IowaScaledEngineering/mrbw-sat/doc/bill-of-materials.ods

Part # | Mfr | Description | Qty | RefDes
LTC3528 | LTC | Step-Up DC/DC | 1 | U1
ATmega328P-AU | Atmel | Microcontroller | 1 | U2
CPDT6-5V4-HF |  | ESD Diodes | 1 | U4
 | Generic | 499k, 1% Resistor (0805) | 1 | R1
 | Generic | 287k, 1% Resistor (0805) | 1 | R2
 | Generic | 1k Resistor (0805) | 3 | R3,R5,R6
 | Generic | 10k Resistor (0805) | 1 | R4
91A1A-B24-(A/B)20L | Bourns | 100k Potentiometer | 1 | P1
 | Generic | 10uF 25V X7R/X5R (0805) | 2 | C2,C4
 | Generic | 33pF 16V NP0 (0805) | 1 | C3
 | Generic | 0.1uF 16V X7R/X5R (0805) | 3 | C5,C6,C7
 | Generic | 22pF 16V NP0 (0805) | 2 | C8,C9
 | Generic | 1uF 16V X7R/X5R (0805) | 2 | C10,C12
 | Generic | 8.2pF 16V NP0 (0805) | 1 | C11
MSS6132-472MLB | Coilcraft | 4.7uH Inductor | 1 | L1
ATS111BSM-1 |  | 11.0592MHz, 18pF Crystal (HC-49-SMT) | 1 | Y1
Si2333DDS |  | P-channel FET | 1 | MP1
SMP4-SBC | Bivar | Red/Green LED | 1 | D1
NPPN101BFLD-RC |  | Xbee Sockets (SMT) | 2 | XU3
M2013ES1W03 | NKK | SPDT Center-Off Toggle Switch | 1 | SW1
D6R90 F1 | C&K | Pushbutton | 1 | SW2
CT2195MST |  | 5-pos DIP switch | 1 | SW3
OSTTC022162 | OST | Dual 0.2" Terminal Blocks | 1 | J1
 |  | 2x3 male header | 6 | J2
1553BBKBAT | Hammond | Case | 1
515-1192-00550F | Dialight | Light Pipe | 1 | For D1
 |  | Knob (user preference, for 1/4” potentiometer shafting) | 1 | For P1
