IowaScaledEngineering/mrbw-sat/pg/mrbw-sat-v1.1-9935337/mrbw-sat-pcb.pdf

# mrbw-sat.pcb

# 1. Table of Contents (This Page) Created on Wed Jul 8 20:06:34 2015

# 2. top 3. bottom 4. outline 5. plated-drill 6. unplated-drill 7. componentmask 8. soldermask 9. topsilk 10. bottomsilk 11. toppaste 12. topassembly 13. bottomassembly 14. fab

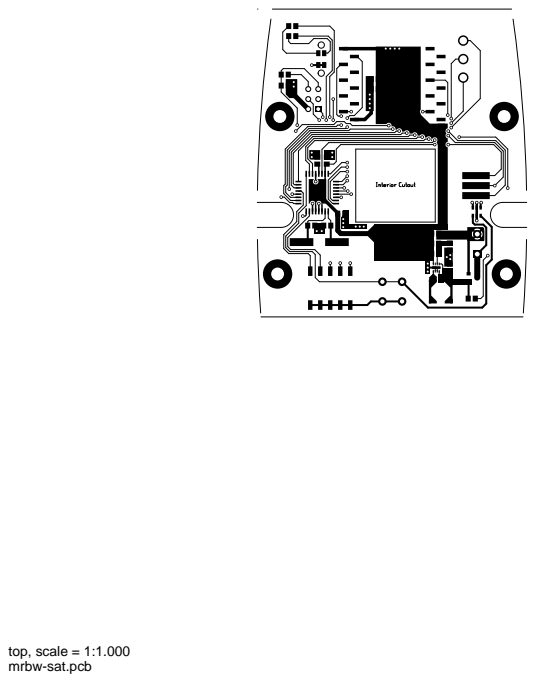
[picture p1: page 2]
top, scale = 1:1.000

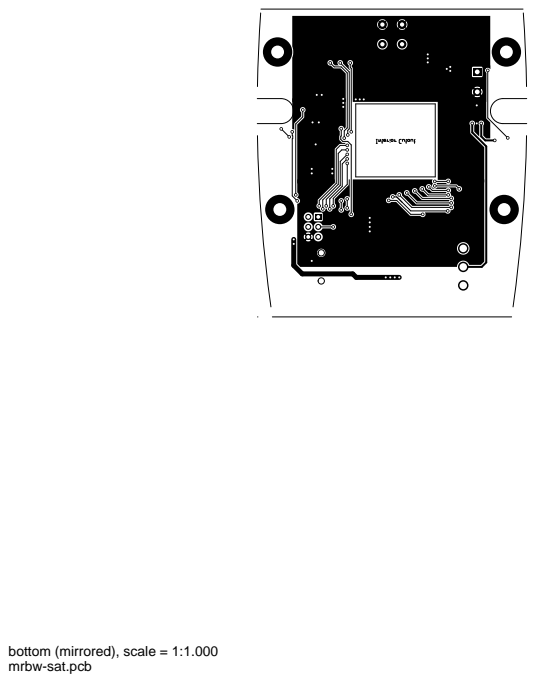
[picture p2: page 3]

bottom (mirrored), scale = 1:1.000

outline, scale = 1:1.000

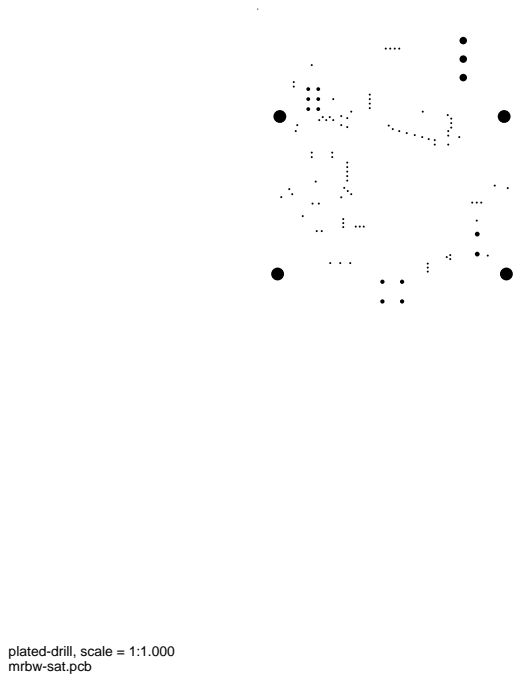
[picture p3: page 5]

plated-drill, scale = 1:1.000

unplated-drill, scale = 1:1.000

topmask, scale = 1:1.000

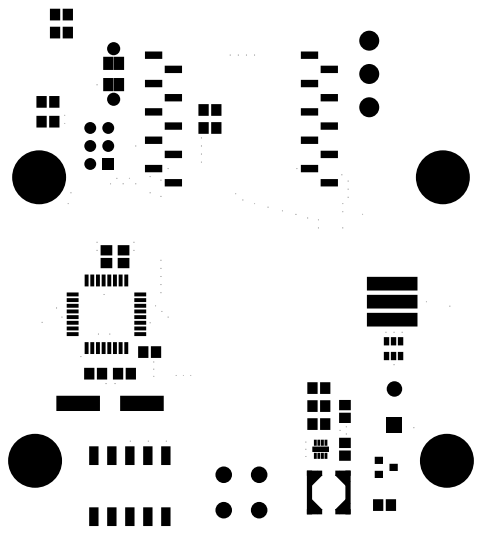
[picture p4: figure]

bottommask (mirrored), scale = 1:1.000

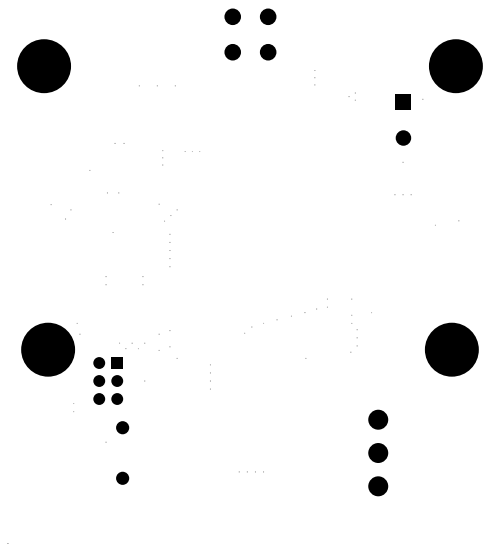
[picture p5: figure]
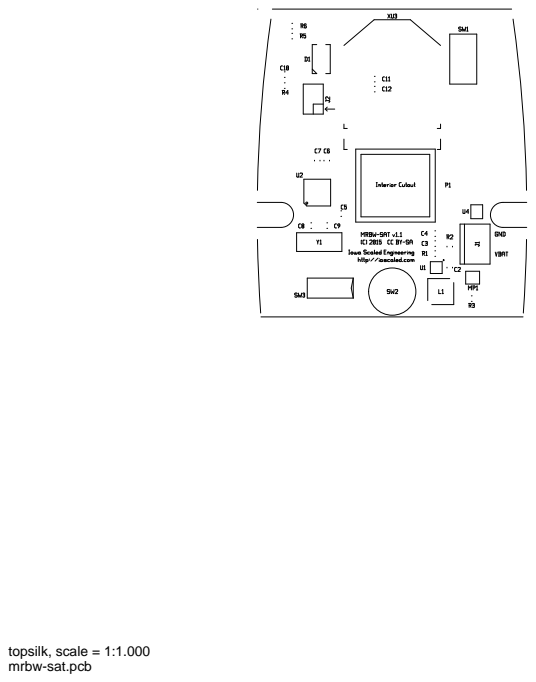
[picture p6: page 9]
topsilk, scale = 1:1.000

bottomsilk (mirrored), scale = 1:1.000

toppaste, scale = 1:1.000

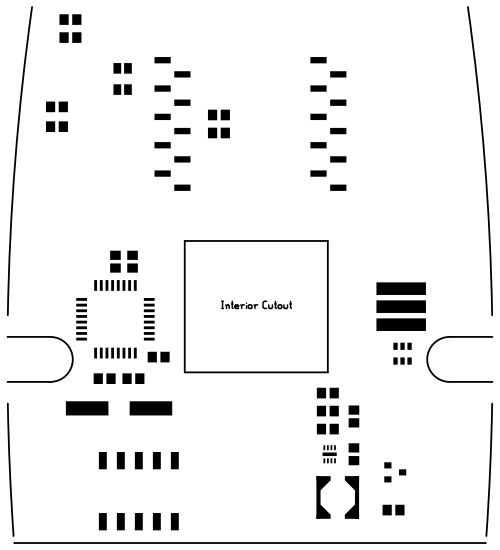
[picture p7: figure]
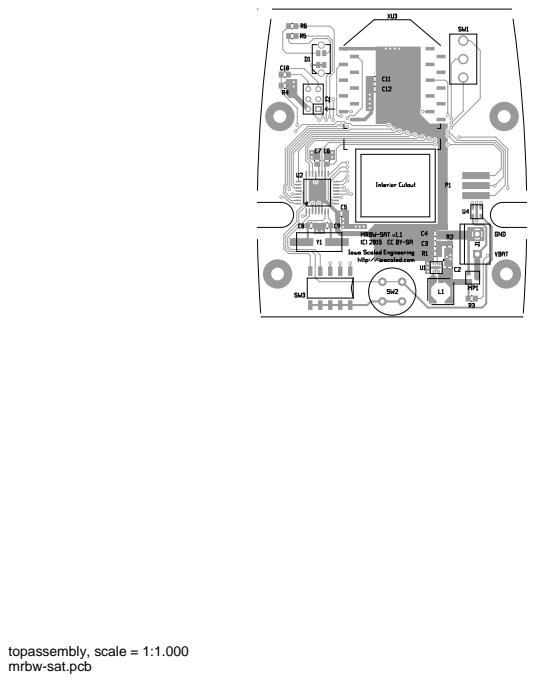
[picture p8: page 12]
topassembly, scale = 1:1.000

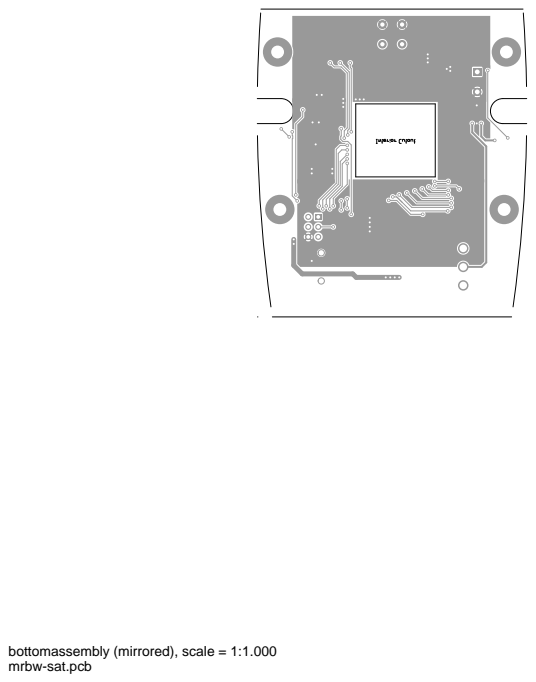
[picture p9: page 13]

bottomassembly (mirrored), scale = 1:1.000

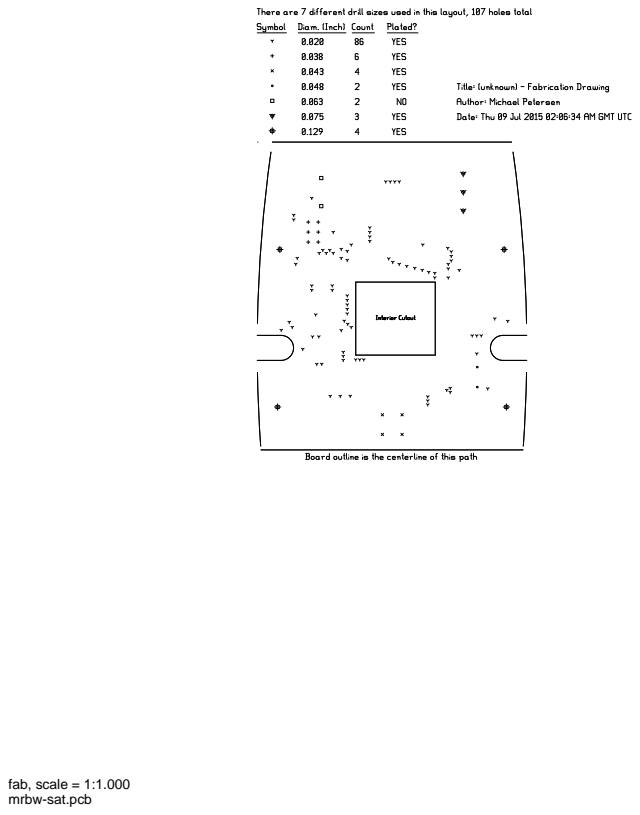
[picture p10: page 14]
fab, scale = 1:1.000
