IowaScaledEngineering/mrbw-sat/pg/mrbw-sat-v1.1-9935337/mrbw-sat.pdf

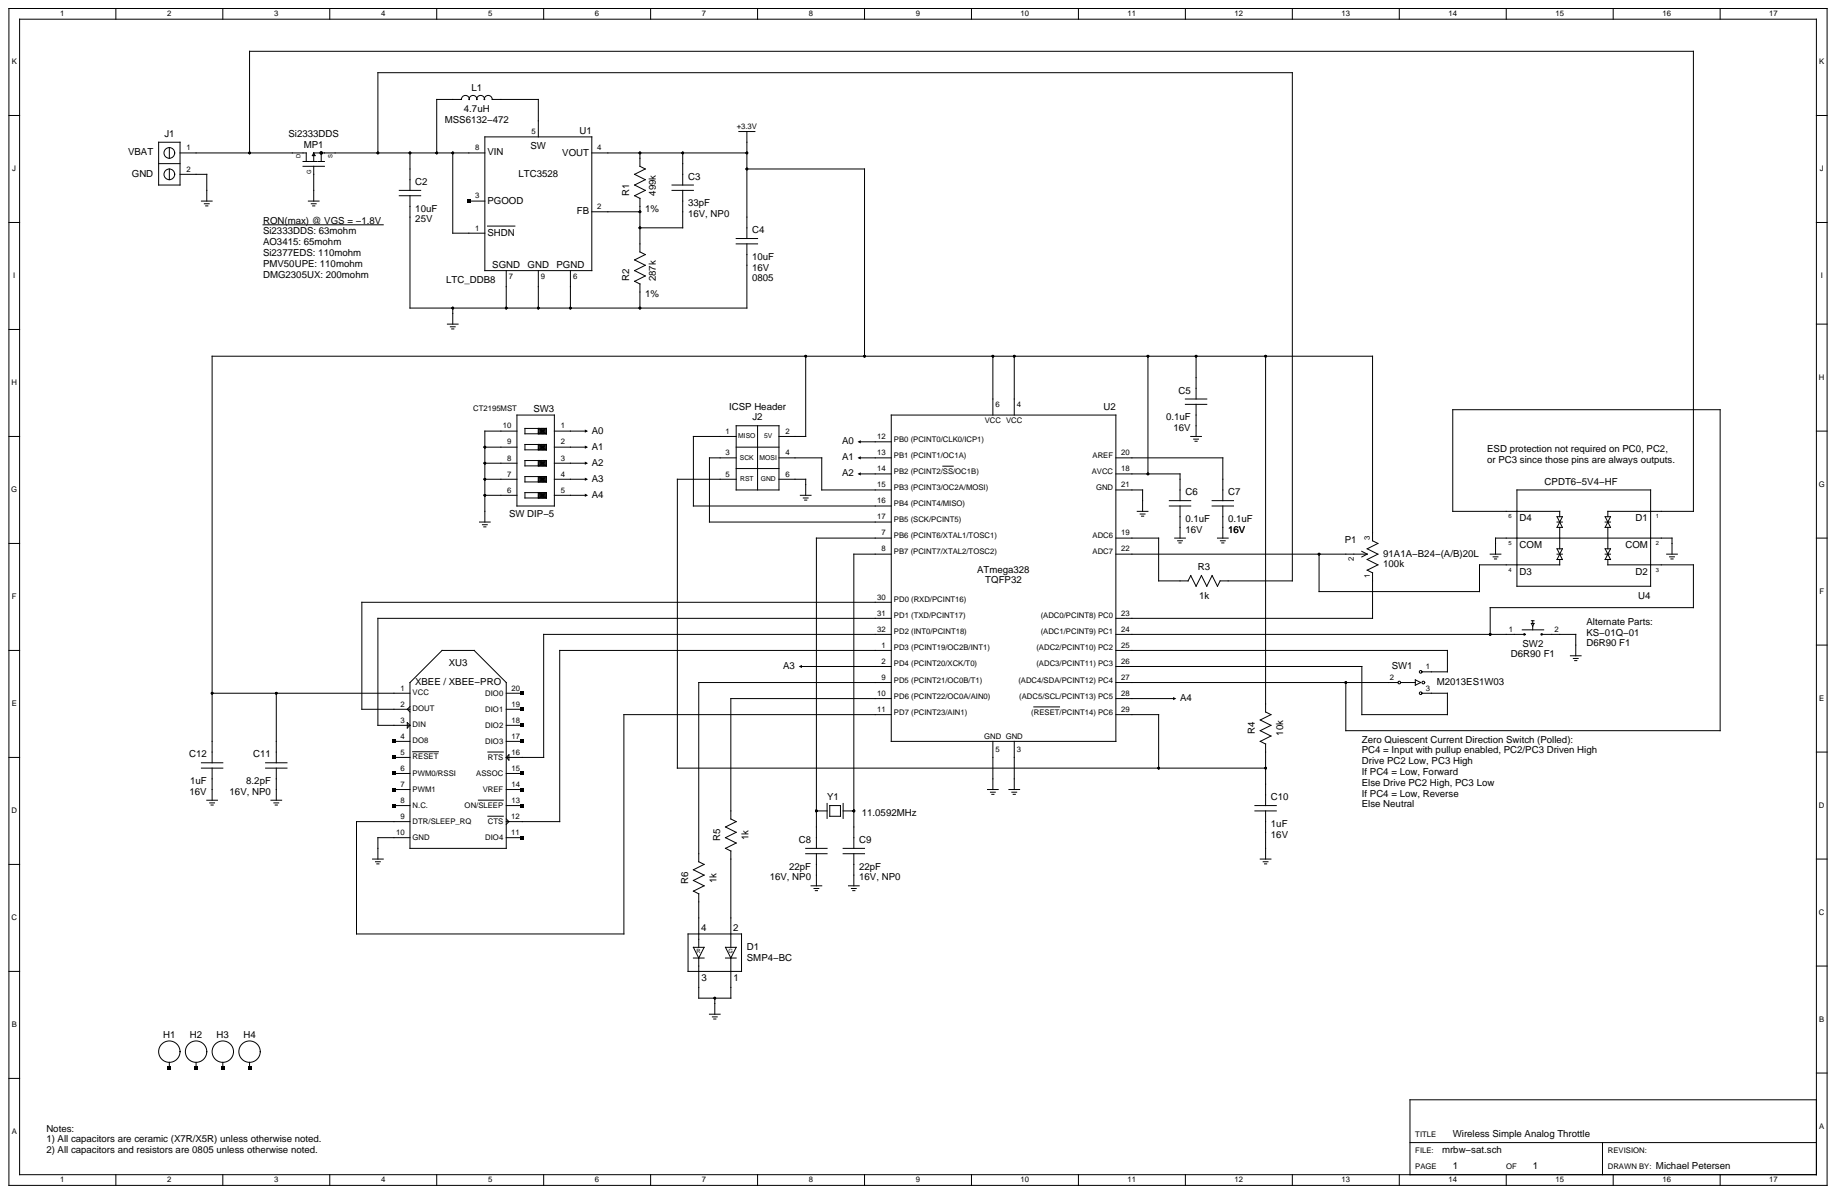
[picture p11: page 1]

ESD protection not required on PC0, PC2,
or PC3 since those pins are always outputs.

Zero Quiescent Current Direction Switch (Polled):
PC4 = Input with pullup enabled, PC2/PC3 Driven High
Drive PC2 Low, PC3 High
If PC4 = Low, Forward
Else Drive PC2 High, PC3 Low
If PC4 = Low, Reverse
Else Neutral

Notes:
1) All capacitors are ceramic (X7R/X5R) unless otherwise noted.
2) All capacitors and resistors are 0805 unless otherwise noted.

Wireless Simple Analog Throttle
mrbw−sat.sch
