IowaScaledEngineering/mrbw-sat/pg/mrbw-sat-v1.0-r1273/mrbw-sat-pcb.pdf

# mrbw-sat.pcb

# 1. Table of Contents (This Page) Created on Sun May 24 20:47:13 2015

# 2. top 3. bottom 4. outline 5. plated-drill 6. unplated-drill 7. componentmask 8. soldermask 9. topsilk 10. bottomsilk 11. toppaste 12. topassembly 13. bottomassembly 14. fab

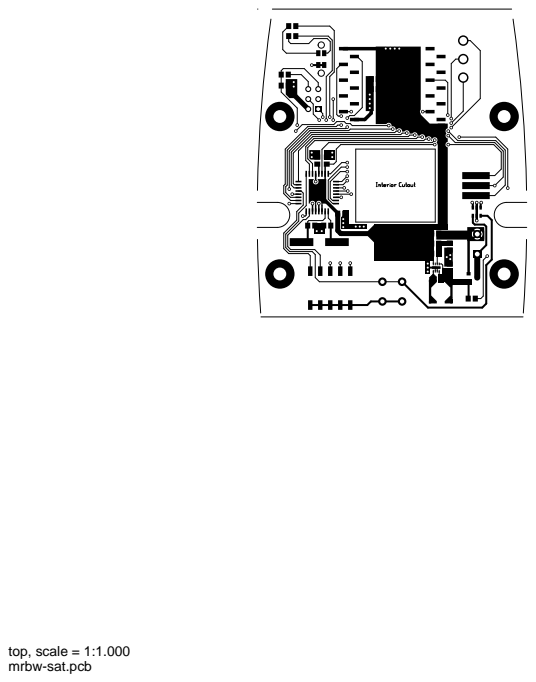
[picture p12: page 2]
top, scale = 1:1.000

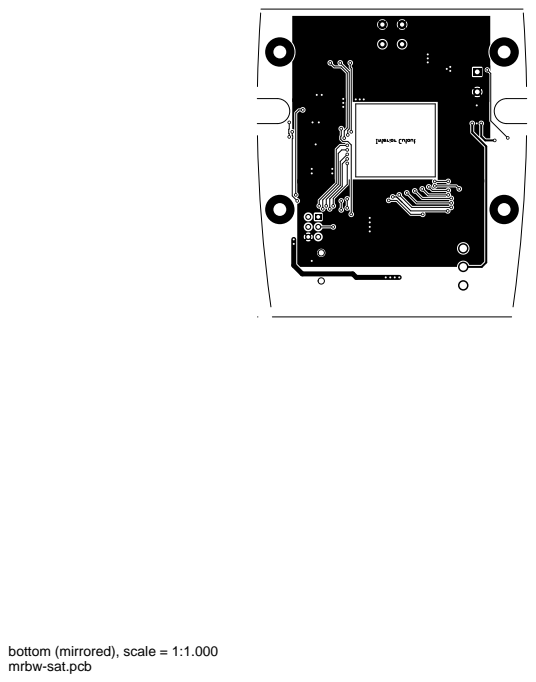
[picture p13: page 3]

bottom (mirrored), scale = 1:1.000

outline, scale = 1:1.000

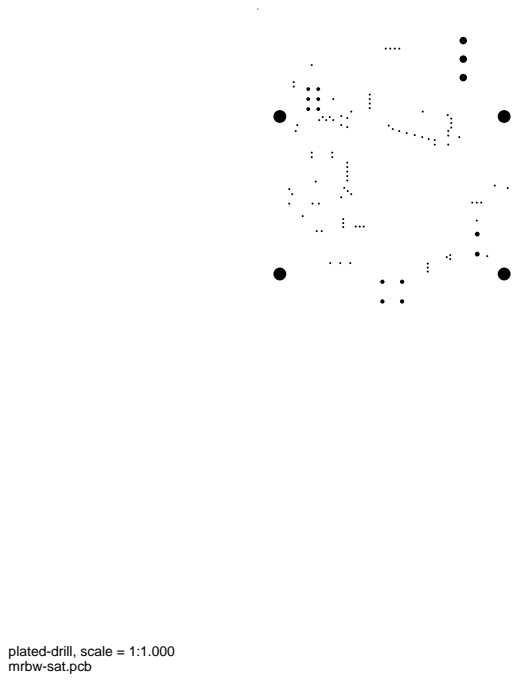
[picture p14: page 5]

plated-drill, scale = 1:1.000

unplated-drill, scale = 1:1.000

topmask, scale = 1:1.000

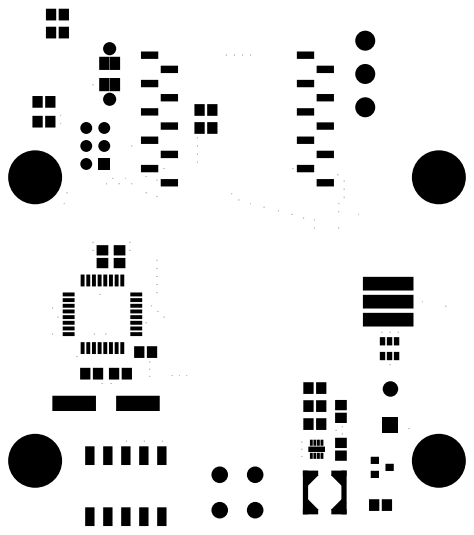
[picture p15: figure]

bottommask (mirrored), scale = 1:1.000

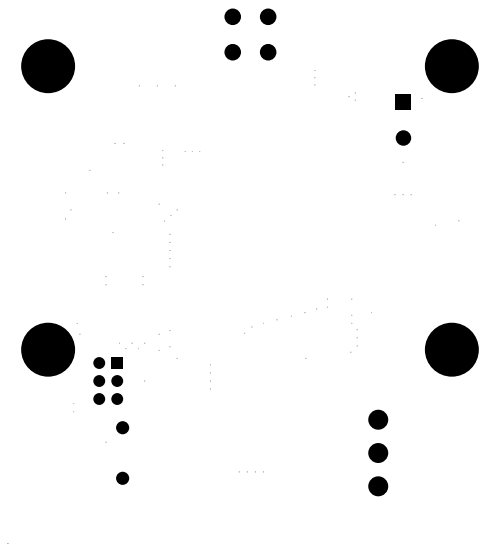
[picture p16: figure]
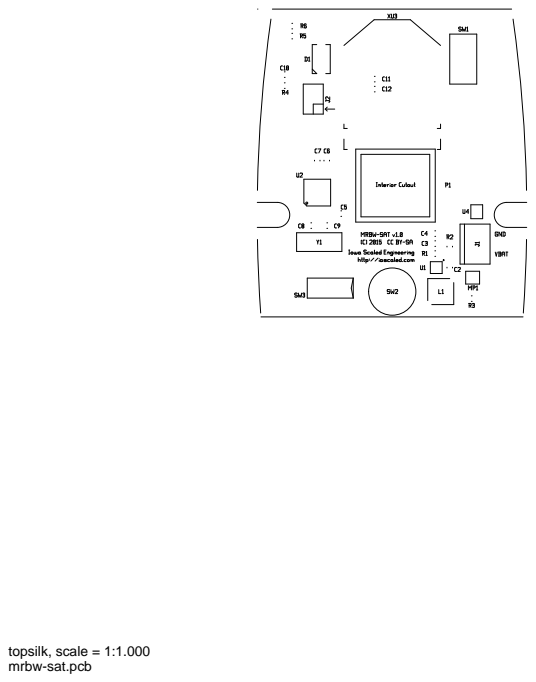
[picture p17: page 9]
topsilk, scale = 1:1.000

bottomsilk (mirrored), scale = 1:1.000

toppaste, scale = 1:1.000

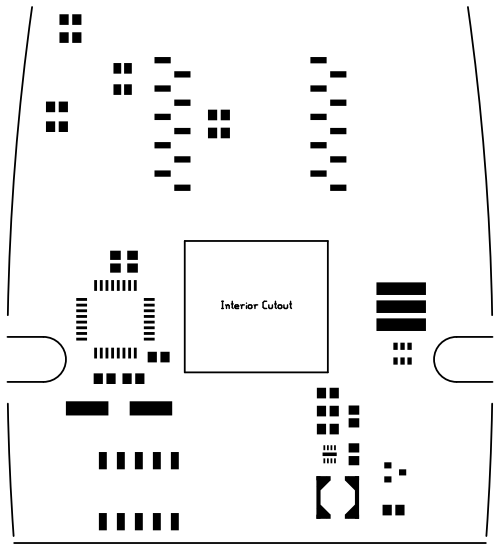
[picture p18: figure]
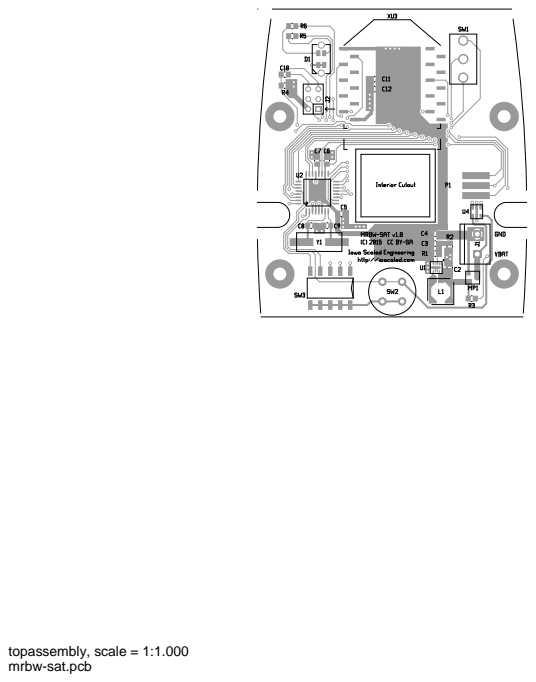
[picture p19: page 12]
topassembly, scale = 1:1.000

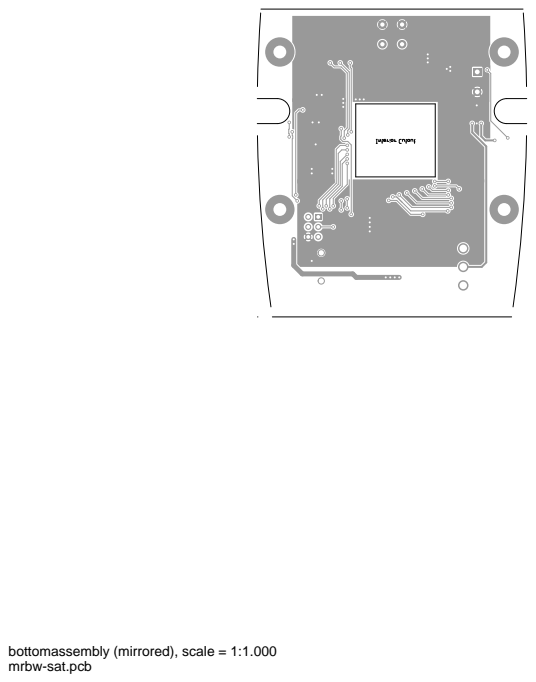
[picture p20: page 13]

bottomassembly (mirrored), scale = 1:1.000

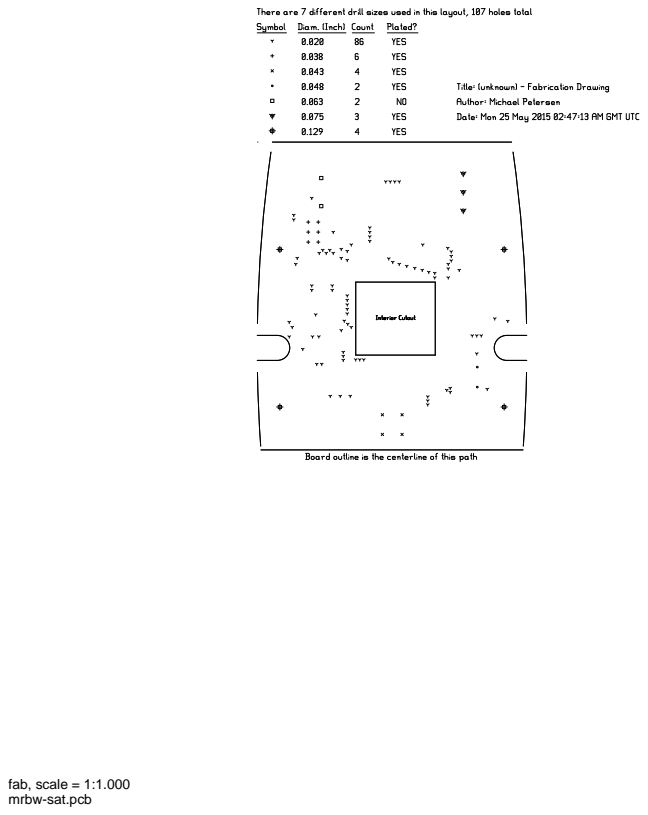
[picture p21: page 14]
fab, scale = 1:1.000
