IowaScaledEngineering/mrbw-sat/(list of files, drawings)

Other design files:
pcb/case.pcb
pcb/mrbw-sat.pcb
