IowaScaledEngineering/mrbw-sat/(commit log)

2014-08-01 Simple analog throttle code
2015-05-07 Initial schematic
2015-05-07 Actual schematic this time
    [mrbw-sat.sch]
2015-05-08 Added indicator LED
    [mrbw-sat.sch]
2015-05-16 Cleaned up part numbers and footprints
    [mrbw-sat.sch]
2015-05-16 Added toggle switch
    [mrbw-sat.sch]
2015-05-16 Initial PCB sketch
    [mrbw-sat.pcb]
2015-05-16 Cutouts for mounting bosses
    [mrbw-sat.pcb]
2015-05-16 Added holes
    [mrbw-sat.pcb]
2015-05-19 Added pin numbers to switch
    [mrbw-sat.sch]
2015-05-20 Initial placement
    [mrbw-sat.pcb, mrbw-sat.sch]
2015-05-22 Changed to SMT xtal. Tweaked placement
    [mrbw-sat.pcb, mrbw-sat.sch]
2015-05-23 Layout start Fixed LTC3528 symbol attributes
    [mrbw-sat.pcb]
2015-05-23 LVS/DRC clean.
    [mrbw-sat.pcb, mrbw-sat.sch]
2015-05-23 Moved center terminal of switch away from DOUT
    [mrbw-sat.pcb]
2015-05-23 Changed switch to a flat toggle model
    [mrbw-sat.pcb, mrbw-sat.sch]
2015-05-23 Widened 3.3V traces
    [mrbw-sat.pcb]
2015-05-23 Copied in correct outline arcs, removed potentiometer circles
    [mrbw-sat.pcb]
2015-05-23 CHanged U1 refdes size back to 45mil
    [mrbw-sat.pcb]
2015-05-24 Cleaned up text. Beefed up power traces.
    [mrbw-sat.pcb]
2015-05-24 DRC/LVS clean with latest netlist.
    [mrbw-sat.pcb]
2015-05-24 Improved C6/C7 GND
    [mrbw-sat.pcb]
2015-05-25 Pulled apart C8/C9
    [mrbw-sat.pcb]
2015-06-09 Sent to OSH
    [mrbw-sat.bottom.gbr, mrbw-sat.bottommask.gbr, mrbw-sat.bottompaste.gbr, mrbw-sat.bottomsilk.gbr, mrbw-sat.fab.gbr, mrbw-sat.outline.gbr, mrbw-sat.top.gbr, mrbw-sat.topmask.gbr]
2015-07-07 Fix the code to send a packet when shifting to neutral, and to not send a speed when in neutral
    [mrbw-sat.c]
2015-07-09 Fixed side slots and bottom hole spacing to match diagram.
    [mrbw-sat.pcb]
2015-07-09 New v1.1
    [mrbw-sat.bottom.gbr, mrbw-sat.bottommask.gbr, mrbw-sat.bottompaste.gbr, mrbw-sat.bottomsilk.gbr, mrbw-sat.fab.gbr, mrbw-sat.outline.gbr, mrbw-sat.top.gbr, mrbw-sat.topmask.gbr]
2015-07-09 Implement primitive sleeping, function button, led control, etc.
2015-07-27 Add ADC sleeping Factor out pin sleep/active mode setting
2015-08-02 Swapped order of init() and setActivePortDirections() so pullups are active before reading them in init.
    [mrbw-sat.c]
2015-08-02 Set DIP switch pins as inputs in setActivePortDirections(), for when coming out of sleep. Leave AUX button alone in sleep since, if not pressed, it won't draw current. Fixed OCR0A divider for 11.0592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
    [mrbw-sat.c]
2015-08-02 Case drilling template
    [case.pcb]
2015-08-02 Parameterized sleep time. Drive RTS high in sleep mode - fighting pull-up in XBee? Fixed fuse value and enabled brown-out at 2.7V
    [mrbw-sat.c]
2015-08-03 Various improvements: - Replace pin definitions with defines for functionality - Factor out LED routines from ISR - Fix issues with ADC readings getting a bogus value in transition between channels -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
    [mrbw-sat.c]
2017-09-04 Add public bill of materials with pricing/sourcing information removed
    [bill-of-materials.ods]
